onkel-serg/ercp-9spools/STLs/support_9x.STL

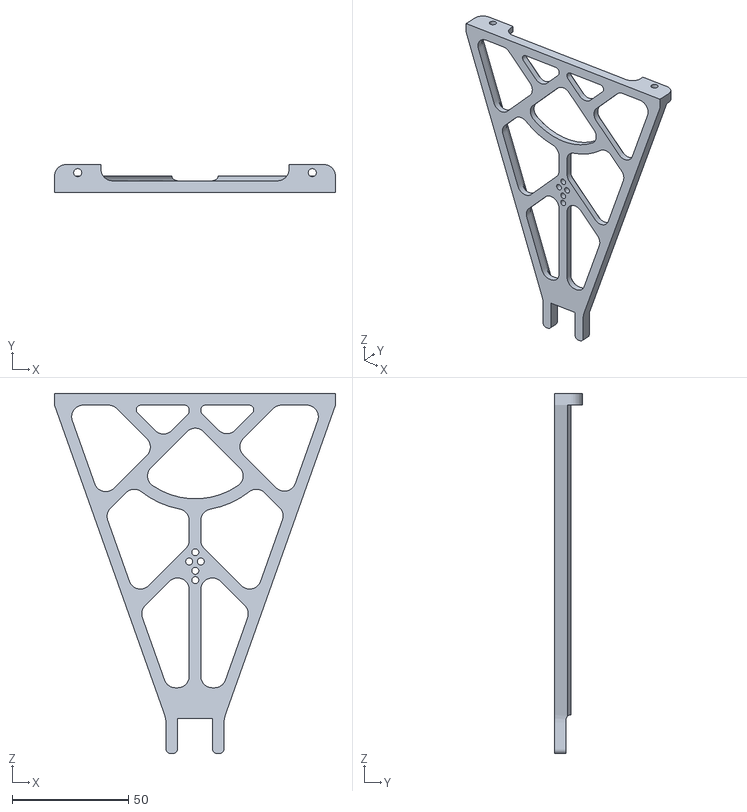
[picture p1: CAD file, 2022-12-07]
STLs/support_9x.STL
121.0 x 12.0 x 155.0
