onkel-serg/ercp-9spools/STLs/mount_ercp_left_2x.STL

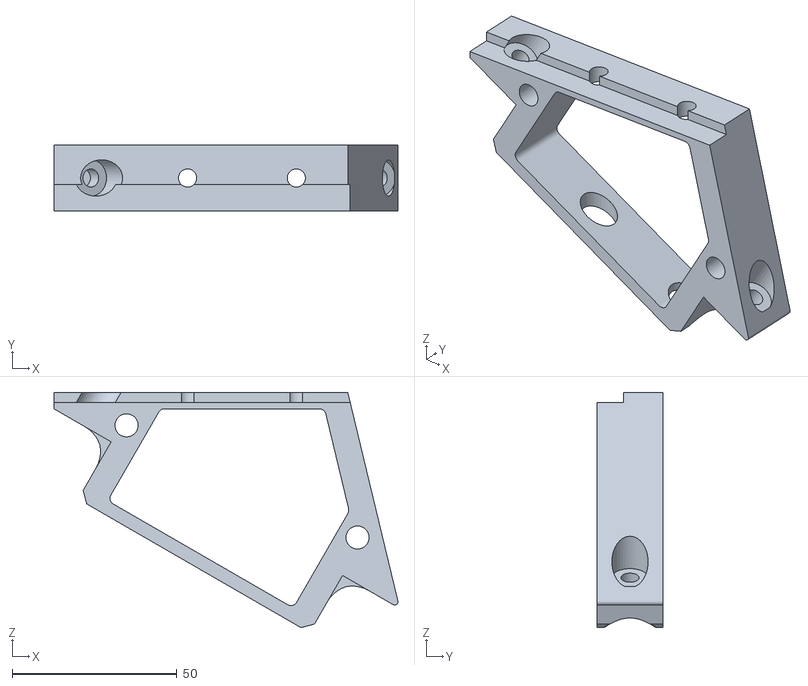
[picture p2: CAD file, 2022-12-07]
STLs/mount_ercp_left_2x.STL
104.3 x 20.0 x 71.3
