onkel-serg/ercp-9spools/STLs/mount_2nd_floor_2x.STL

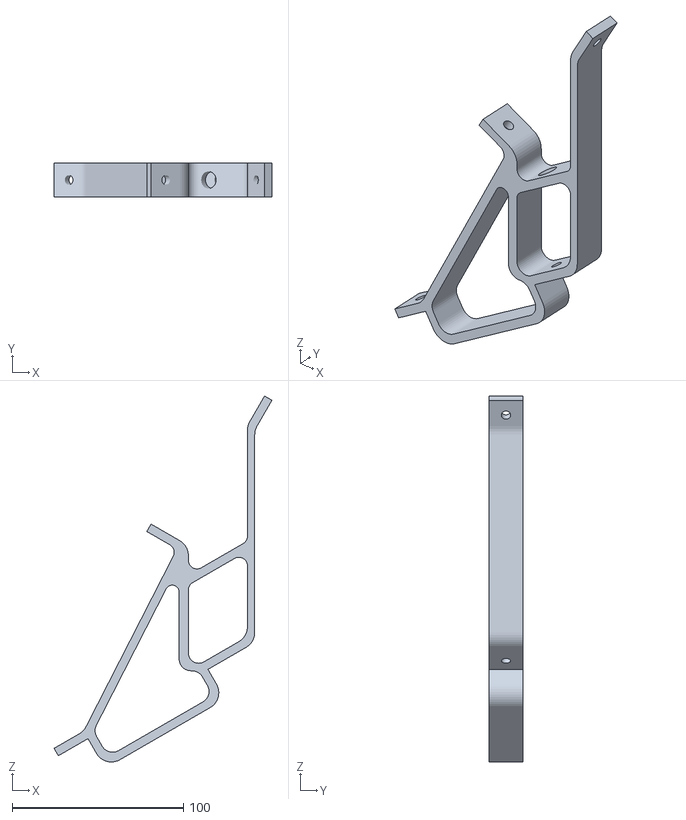
[picture p3: CAD file, 2022-12-07]
STLs/mount_2nd_floor_2x.STL
127.4 x 20.0 x 213.9
