onkel-serg/ercp-9spools/STLs/mount_right.STL

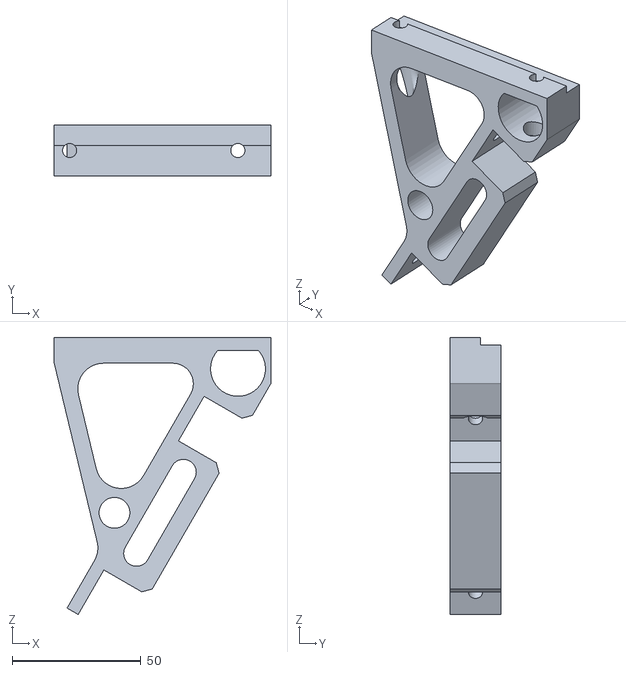
[picture p4: CAD file, 2022-12-07]
STLs/mount_right.STL
84.3 x 20.0 x 107.8
