onkel-serg/ercp-9spools/STLs/spool_round_9x.STL

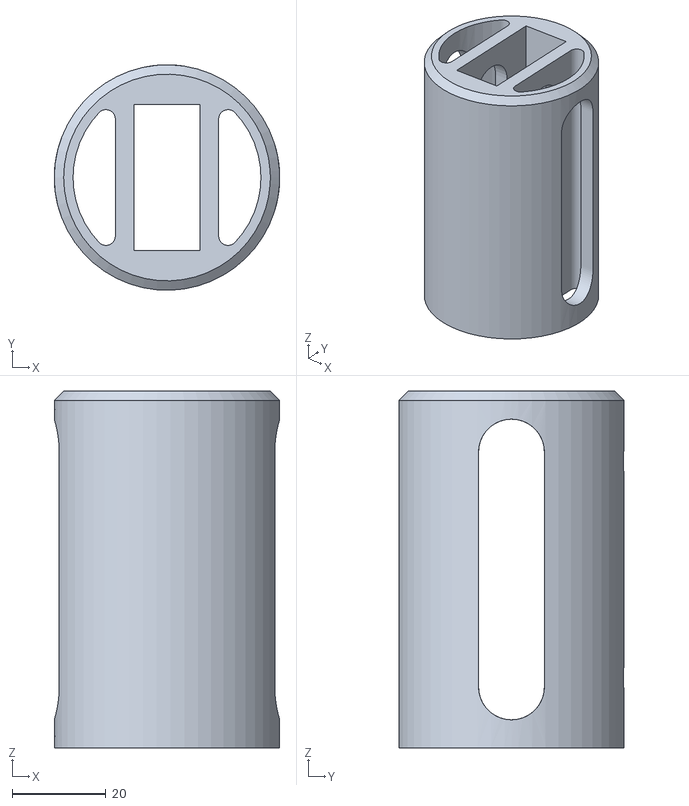
[picture p5: CAD file, 2022-12-07]
STLs/spool_round_9x.STL
48.0 x 48.0 x 76.0
