onkel-serg/ercp-9spools/(list of files, cad)

Other CAD files:
STLs/mount_ercp_right_2x.STL
STLs/mount_left.STL
